pigatron-industries/xen_quantizer/README.md

# Quantizer

A Eurorack quantizer module

[Documentation](https://pigatron-industries.github.io/xen_quantizer/)
