pigatron-industries/xen_quantizer/docs/index.md

---
order: 1
---
# Quantizer

{% include img.html src="images/quantizer_panel.png" height="640" class="floatright" %}

A 4 channel quantizer and sequence generator

## Features
* 4 channel quantizer.
* Can quantize input using alternative tunings, scales and chords.
* Custom tunings and scales can be difined and read from SD card.
* Assignable CV inputs for controllable parameters.
* Includes sequence generation modes for generating sequences of voltages or triggers.
* Uses a Teensy microcontroller + open source code can easily be modified.

## Documentation

* [User Manual](user.md)
* [Bill of Materials](bom.md)
* [Build Guide](build.md)
