pigatron-industries/xen_quantizer/docs/images/quantizer_baseboard_brd.drawio.png

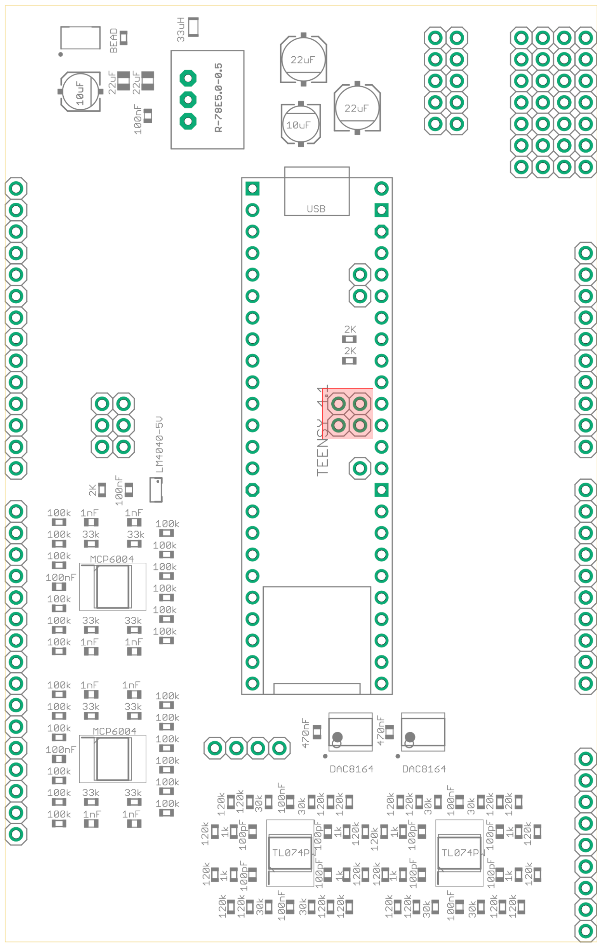
docs/images/quantizer_baseboard_brd.drawio.png
