pigatron-industries/xen_quantizer/docs/images/quantizer_panel.png

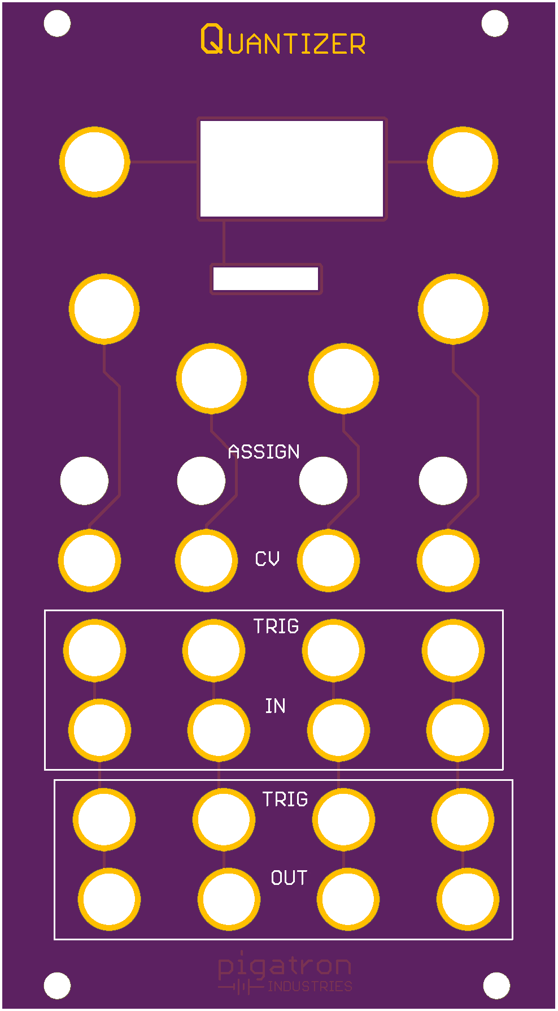
docs/images/quantizer_panel.png
