pigatron-industries/xen_quantizer/hardware/PGTN034_quantizer_mki_panel.png

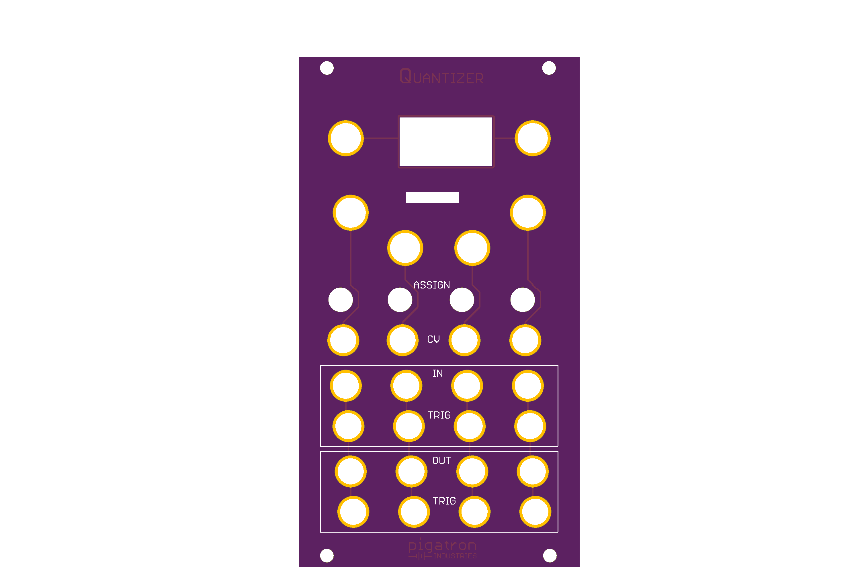
hardware/PGTN034_quantizer_mki_panel.png
