pigatron-industries/xen_quantizer/hardware/xen_teensy_motherboard_8cv8pt_mki.png

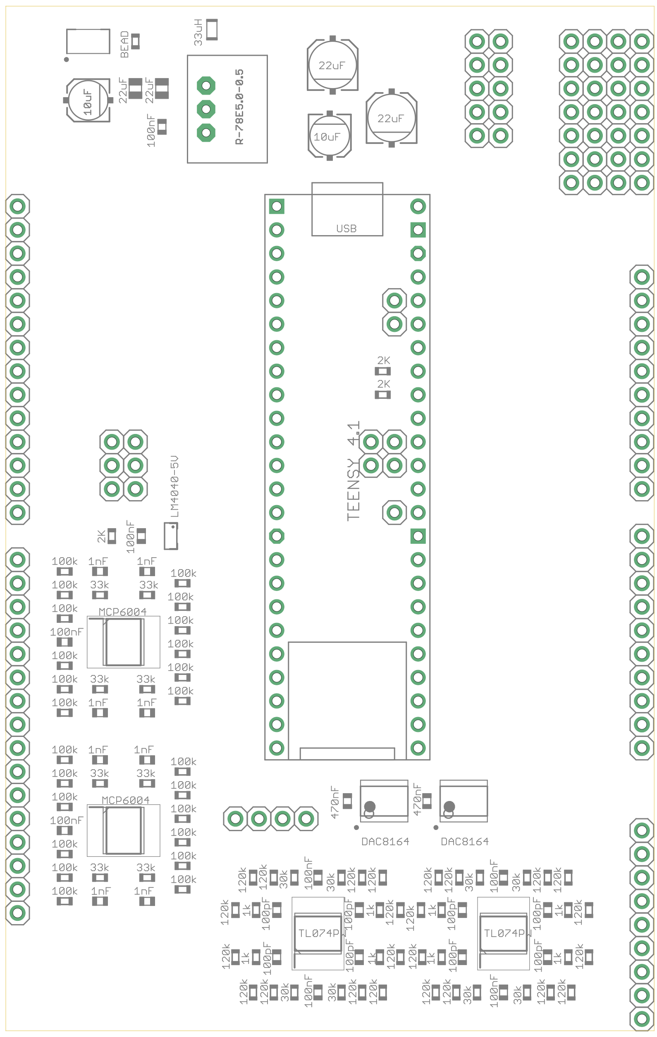
hardware/xen_teensy_motherboard_8cv8pt_mki.png
