pigatron-industries/xen_quantizer/docs/images/quantizer_panel_guide.drawio.png

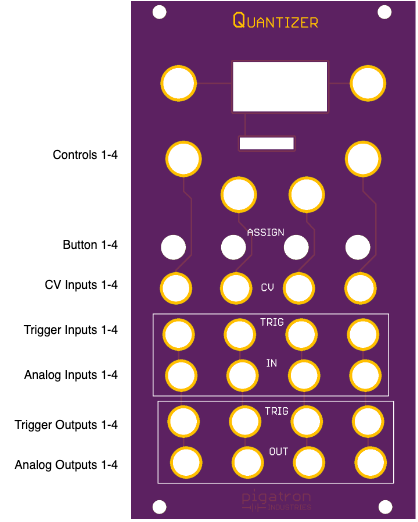
docs/images/quantizer_panel_guide.drawio.png
