pigatron-industries/xen_quantizer/hardware/PGTN034_quantizer_mki_controls.brd

## EAGLE design hardware/PGTN034_quantizer_mki_controls.brd (2024-04-14)

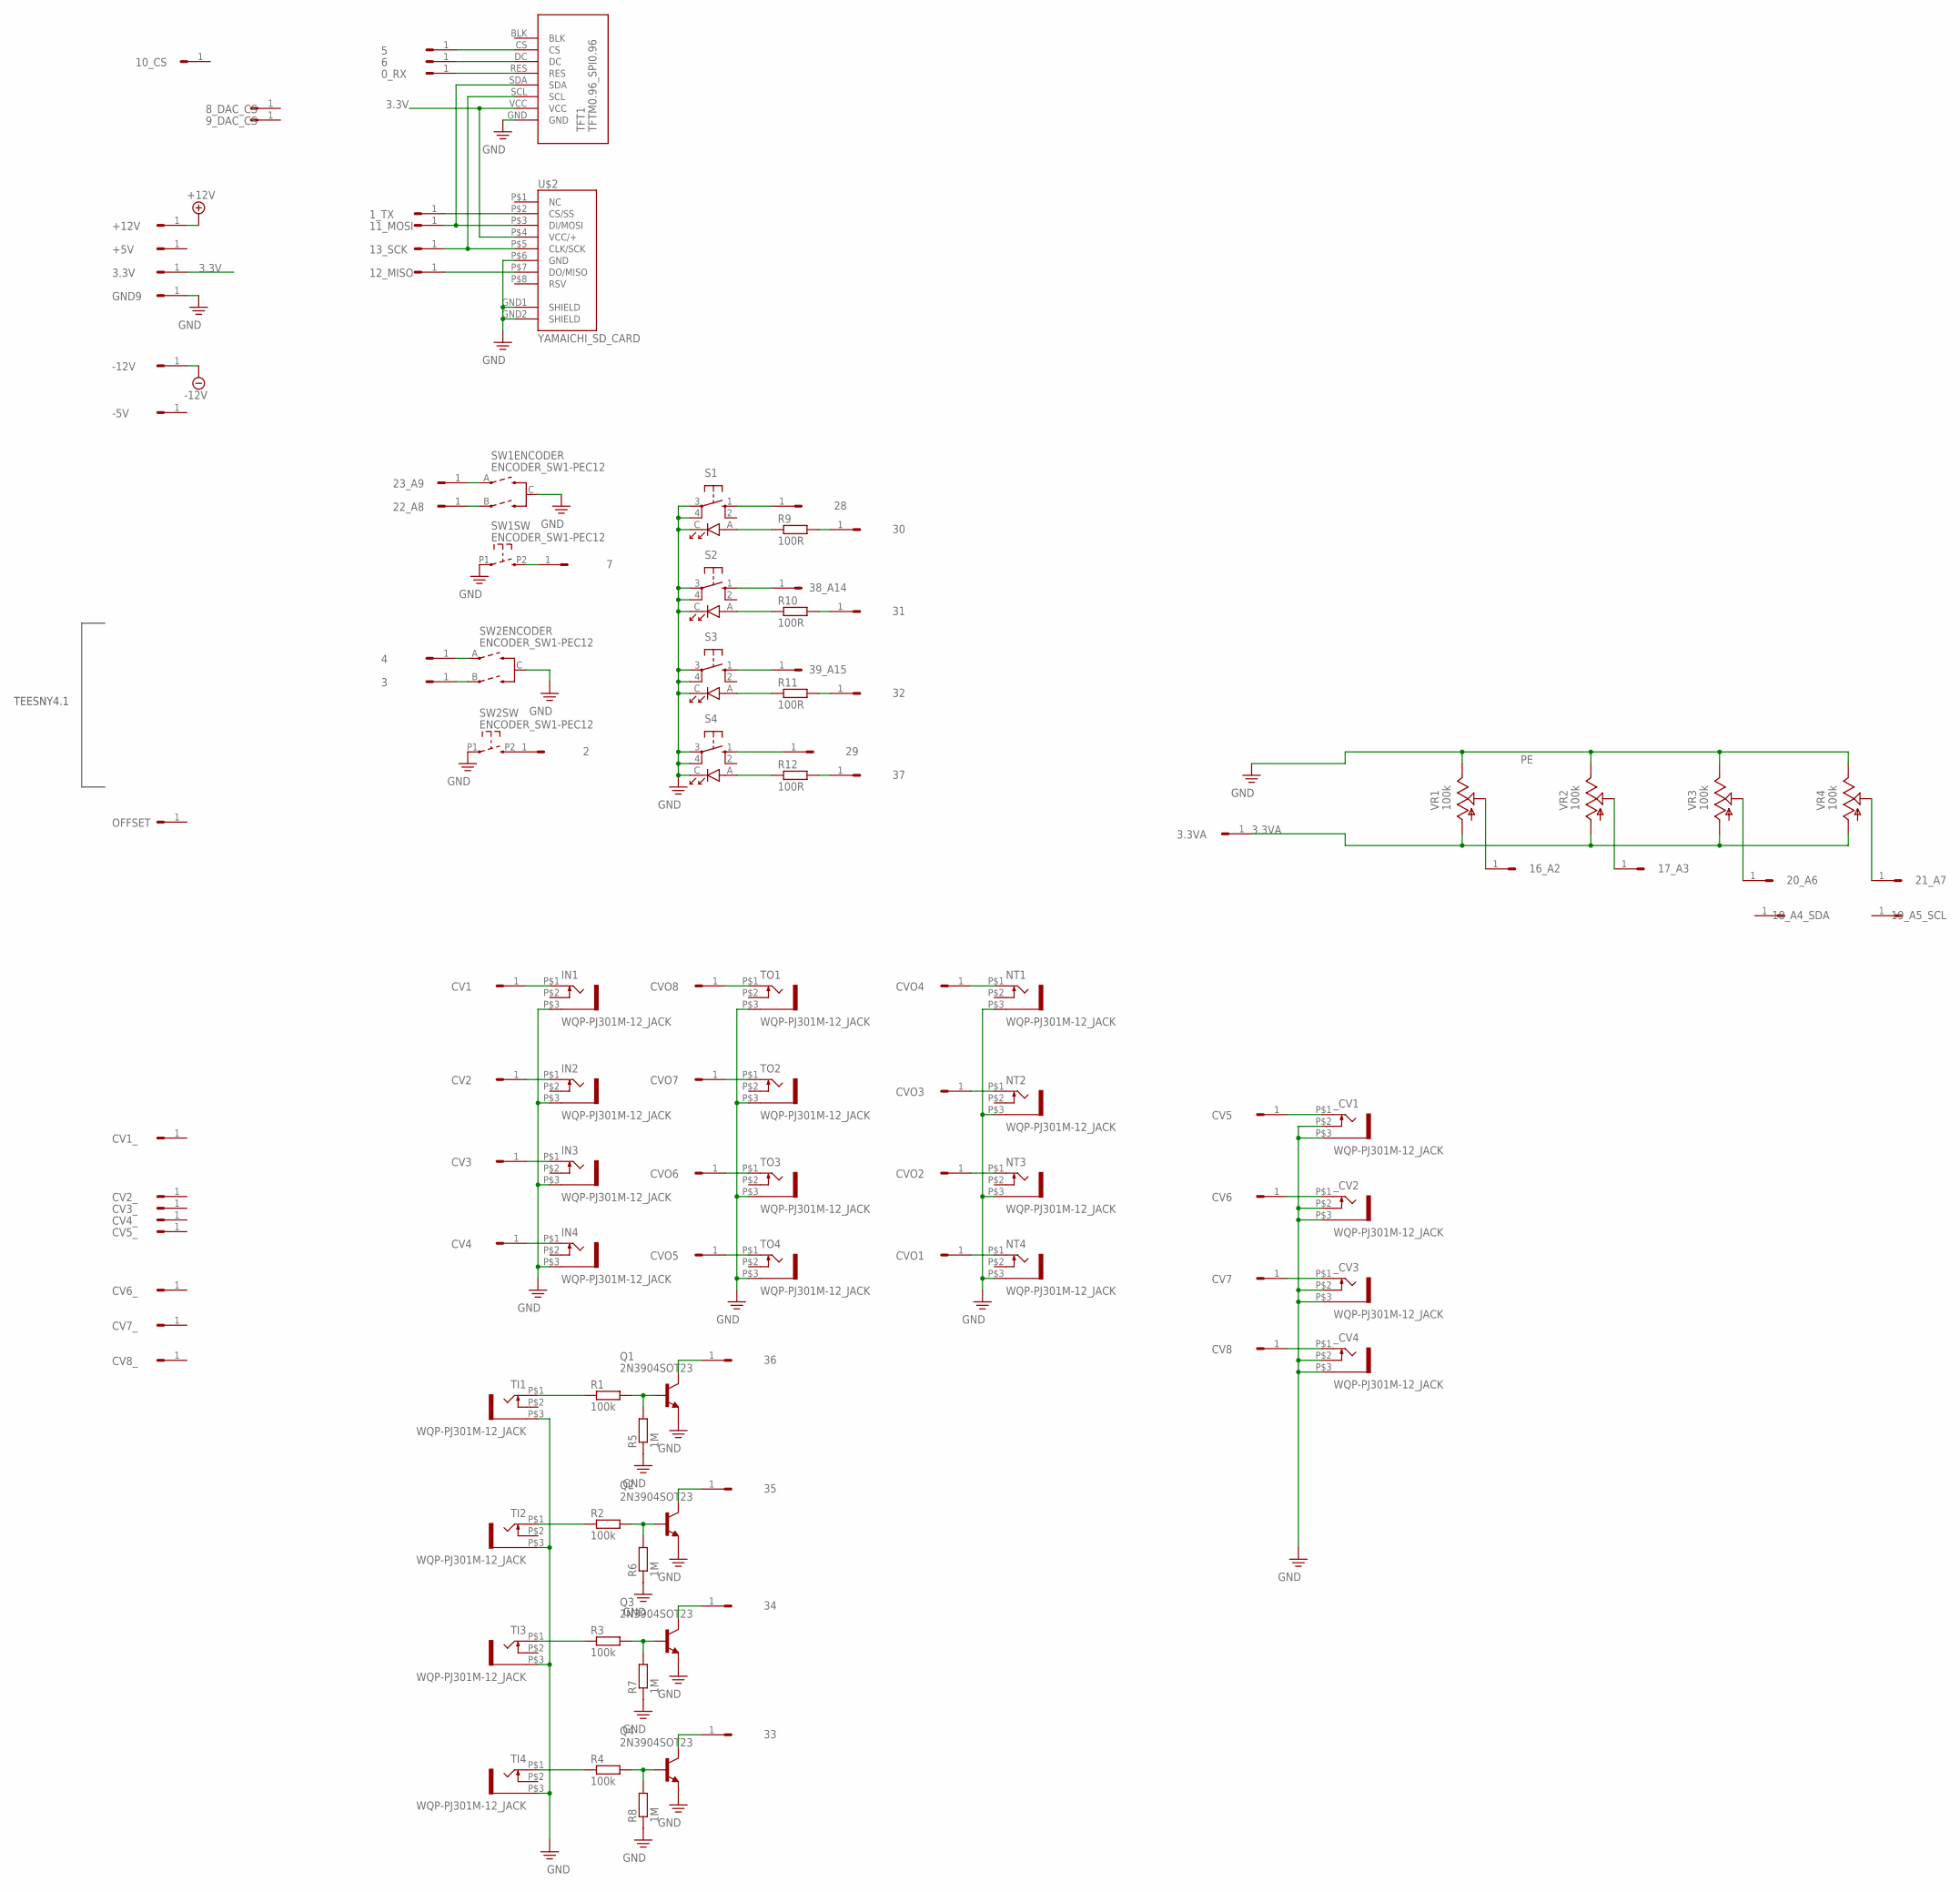
[picture p6: schematic PGTN034_quantizer_mki_controls.sch]

Parts:
0_RX, 1_TX, 2, 3, 3.3V, 3.3VA, 4, 5, 6, 7, 8_DAC_CS, 9_DAC_CS, 10_CS, 11_MOSI, 12_MISO, 13_SCK, 16_A2, 17_A3, 18_A4_SDA, 19_A5_SCL, 20_A6, 21_A7, 22_A8, 23_A9, 28, 29, 30, 31, 32, 33, 34, 35, 36, 37, 38_A14, 39_A15: HEADER/MALE/01
+5V, +12V: HEADER/MALE/01
-5V, -12V: HEADER/MALE/01
CV1, CV1_, CV2, CV2_, CV3, CV3_, CV4, CV4_, CV5, CV5_, CV6, CV6_, CV7, CV7_, CV8, CV8_: HEADER/MALE/01
CVO1, CVO2, CVO3, CVO4, CVO5, CVO6, CVO7, CVO8: HEADER/MALE/01
GND9: HEADER/MALE/01
IN1, IN2, IN3, IN4: WQP-PJ301M-12_JACK
NT1, NT2, NT3, NT4: WQP-PJ301M-12_JACK
OFFSET: HEADER/MALE/01
Q1, Q2, Q3, Q4: 2N3904SOT23; SOT23
R1, R2, R3, R4: 100k; R0603
R5, R6, R7, R8: 1M; R0603
R9, R10, R11, R12: 100R; R0603
S1, S2, S3, S4: SW-LEDTHONK; SW-PUSH-TACT-LED-THONK
SW1, SW2: ENCODER_SW1-PEC12; PEC12_INCREMENTAL_ENCODER
TFT1: TFTM0.96_SPI0.96; TFTM0.96
TI1, TI2, TI3, TI4: WQP-PJ301M-12_JACK
TO1, TO2, TO3, TO4: WQP-PJ301M-12_JACK
U$2: YAMAICHI_SD_CARD; YAMAICHI_MICROSD_VERTICAL
VR1, VR2, VR3, VR4: 100k; 9MM_SNAP-IN_POT
_CV1, _CV2, _CV3, _CV4: WQP-PJ301M-12_JACK

Connections:
3.3V: 3.3V.1, TFT1.VCC, U$2.P$4 (VCC/+)
3.3VA: 3.3VA.1, VR1.1 (A), VR2.1 (A), VR3.1 (A), VR4.1 (A)
+12V: +12V.1
-12V: -12V.1
unnamed: CV5.1, _CV1.P$1 (2)
unnamed: 16_A2.1, VR1.2 (S)
unnamed: CV6.1, _CV2.P$1 (2)
unnamed: 0_RX.1, TFT1.RES
unnamed: CVO1.1, NT4.P$1 (2)
unnamed: CVO2.1, NT3.P$1 (2)
unnamed: 17_A3.1, VR2.2 (S)
unnamed: CVO3.1, NT2.P$1 (2)
unnamed: 20_A6.1, VR3.2 (S)
unnamed: 21_A7.1, VR4.2 (S)
unnamed: CVO4.1, NT1.P$1 (2)
unnamed: CVO5.1, TO4.P$1 (2)
unnamed: CVO6.1, TO3.P$1 (2)
unnamed: CVO7.1, TO2.P$1 (2)
unnamed: CVO8.1, TO1.P$1 (2)
unnamed: CV1.1, IN1.P$1 (2)
unnamed: CV2.1, IN2.P$1 (2)
unnamed: CV3.1, IN3.P$1 (2)
unnamed: CV4.1, IN4.P$1 (2)
unnamed: CV7.1, _CV3.P$1 (2)
unnamed: CV8.1, _CV4.P$1 (2)
unnamed: R1.1, TI1.P$1 (2)
unnamed: R2.1, TI2.P$1 (2)
unnamed: R3.1, TI3.P$1 (2)
unnamed: R4.1, TI4.P$1 (2)
unnamed: Q1.1 (B), R1.2, R5.2
unnamed: Q2.1 (B), R2.2, R6.2
unnamed: Q3.1 (B), R3.2, R7.2
unnamed: Q4.1 (B), R4.2, R8.2
unnamed: 36.1, Q1.3 (C)
unnamed: 35.1, Q2.3 (C)
unnamed: 34.1, Q3.3 (C)
unnamed: 33.1, Q4.3 (C)
unnamed: R9.1, S1.A
unnamed: R12.1, S4.A
unnamed: 7.1, SW1.P2 (2)
unnamed: 23_A9.1, SW1.A
unnamed: 22_A8.1, SW1.B
unnamed: R11.1, S3.A
unnamed: R10.1, S2.A
unnamed: 28.1, S1.1 (S)
unnamed: 38_A14.1, S2.1 (S)
unnamed: 39_A15.1, S3.1 (S)
unnamed: 29.1, S4.1 (S)
unnamed: 31.1, R10.2
unnamed: 30.1, R9.2
unnamed: 32.1, R11.2
unnamed: 37.1, R12.2
unnamed: 12_MISO.1, U$2.P$7 (DO/MISO)
unnamed: 11_MOSI.1, TFT1.SDA, U$2.P$3 (DI/MOSI)
unnamed: 13_SCK.1, TFT1.SCL, U$2.P$5 (CLK/SCK)
unnamed: 5.1, TFT1.CS
unnamed: 6.1, TFT1.DC
unnamed: 3.1, SW2.B
unnamed: 4.1, SW2.A
unnamed: 2.1, SW2.P2 (2)
unnamed: 1_TX.1, U$2.P$2 (CS/SS)
PE: GND9.1, IN1.P$3 (1), IN2.P$3 (1), IN3.P$3 (1), IN4.P$3 (1), NT1.P$3 (1), NT2.P$3 (1), NT3.P$3 (1), NT4.P$3 (1), Q1.2 (E), Q2.2 (E), Q3.2 (E), Q4.2 (E), R5.1, R6.1, R7.1, R8.1, S1.3, S1.4 (P1), S1.C, S2.3, S2.4 (P1), S2.C, S3.3, S3.4 (P1), S3.C, S4.3, S4.4 (P1), S4.C, SW1.C, SW1.P1 (1), SW2.C, SW2.P1 (1), TFT1.GND, TI1.P$3 (1), TI2.P$3 (1), TI3.P$3 (1), TI4.P$3 (1), TO1.P$3 (1), TO2.P$3 (1), TO3.P$3 (1), TO4.P$3 (1), U$2.GND1 (SHIELD), U$2.GND2 (SHIELD), U$2.P$6 (GND), VR1.3 (E), VR2.3 (E), VR3.3 (E), VR4.3 (E), _CV1.P$2 (3), _CV1.P$3 (1), _CV2.P$2 (3), _CV2.P$3 (1), _CV3.P$2 (3), _CV3.P$3 (1), _CV4.P$2 (3), _CV4.P$3 (1)

Notes on the sheet:
TEESNY4.1

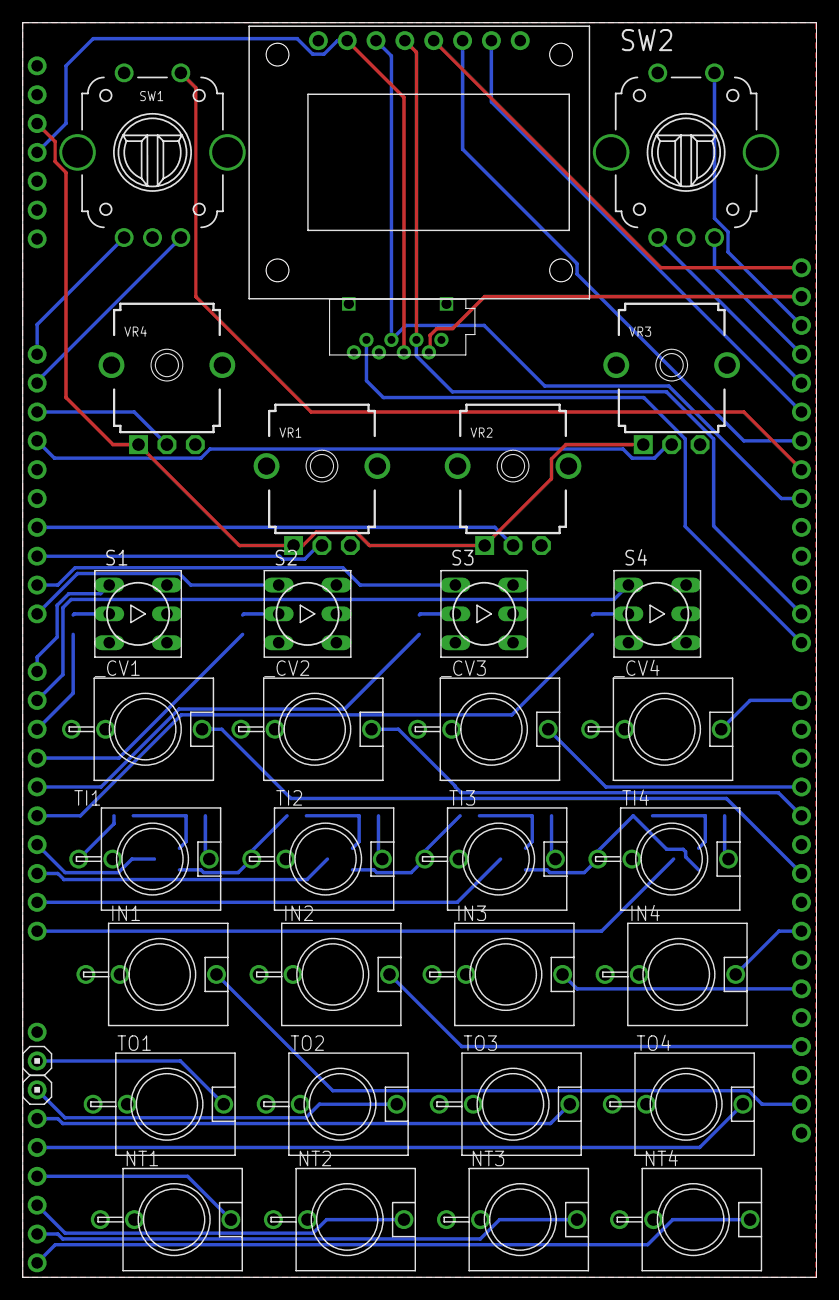
[picture p7: board PGTN034_quantizer_mki_controls.brd from above]

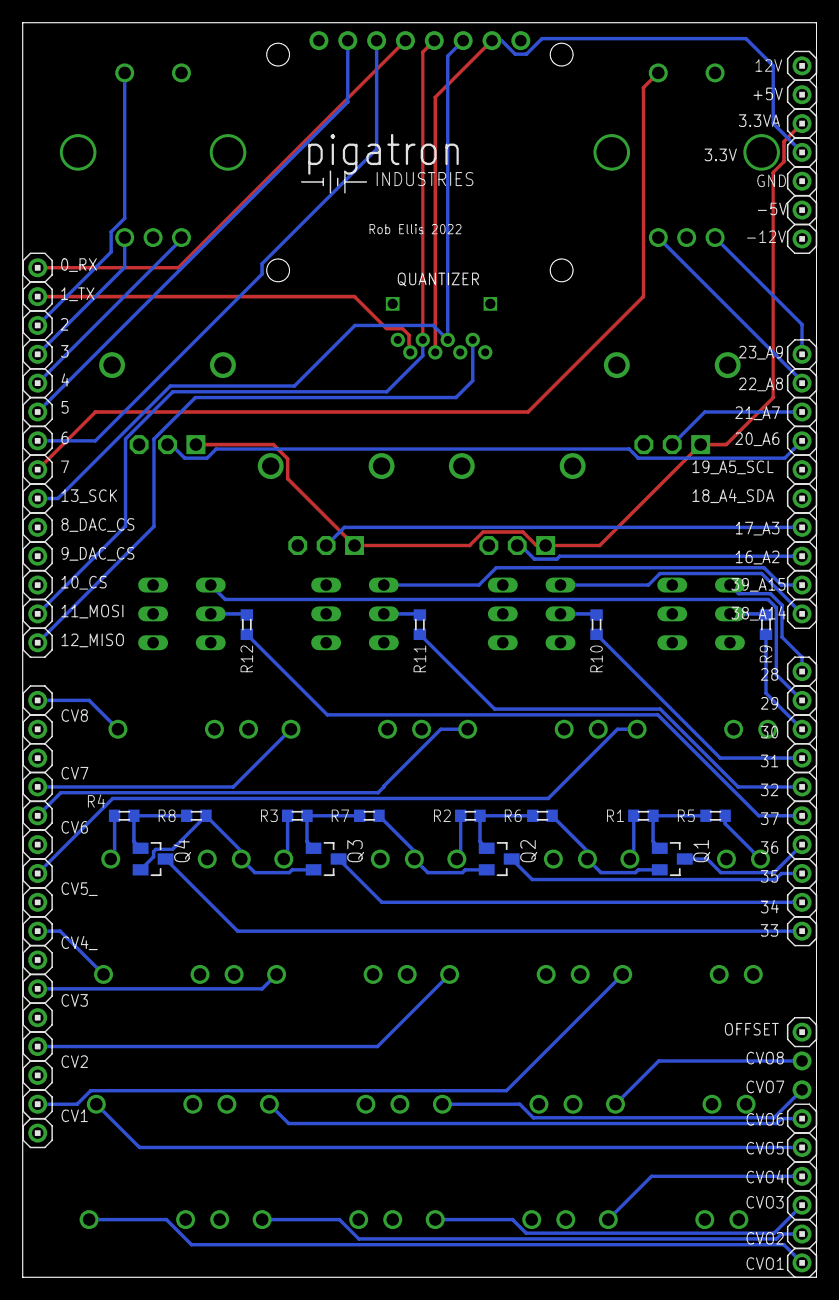
[picture p8: board PGTN034_quantizer_mki_controls.brd from below]

Board: 2 copper layers, 69.9 x 110.5 mm, 115 parts (81 on the bottom side), 60 nets.

Other parts of the board:
U$1: PIGATRON-LOGO
