pigatron-industries/xen_quantizer/hardware/PGTN034_quantizer_mki_panel.brd

## EAGLE design hardware/PGTN034_quantizer_mki_panel.brd (2023-10-22)

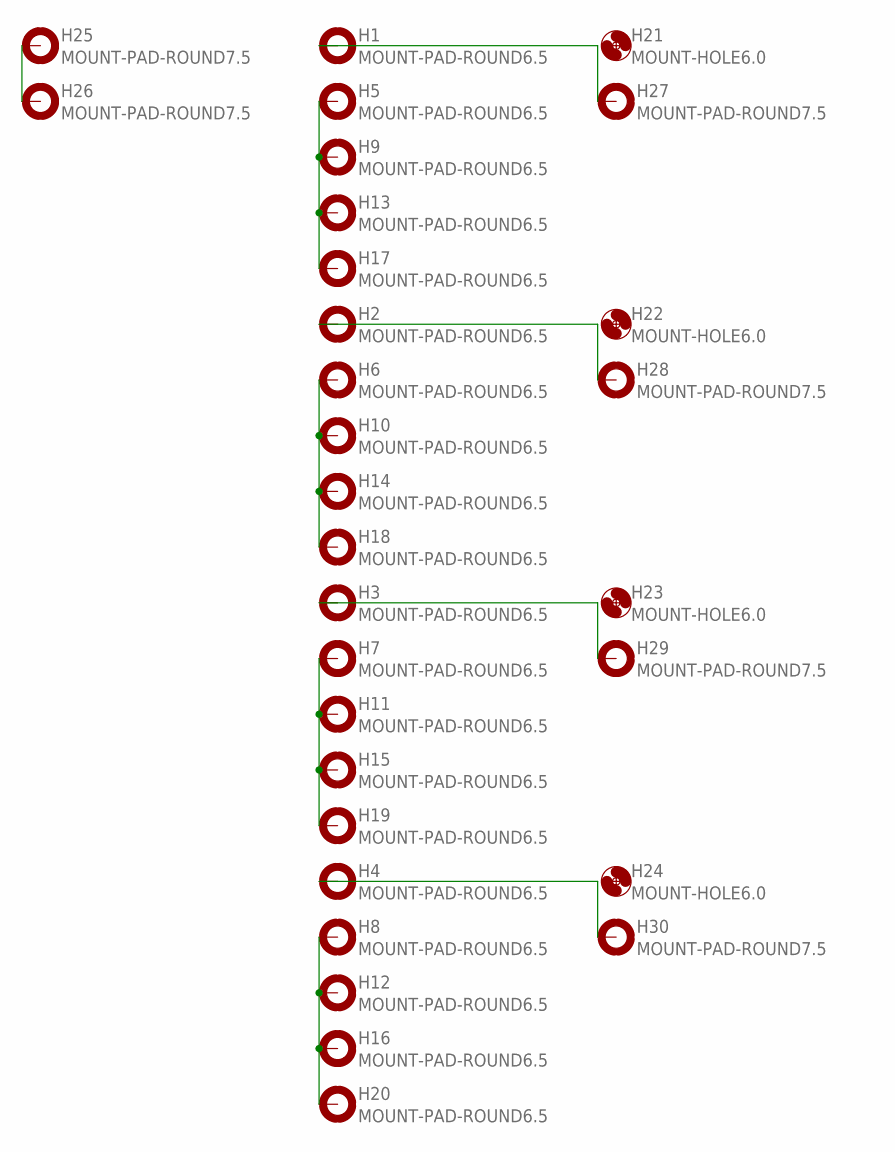
[picture p9: schematic PGTN034_quantizer_mki_panel.sch]

Parts:
H1, H2, H3, H4, H5, H6, H7, H8, H9, H10, H11, H12, H13, H14, H15, H16, H17, H18, H19, H20: MOUNT-PAD-ROUND6.5; 6.5-PAD
H21, H22, H23, H24: MOUNT-HOLE6.0; 6,0
H25, H26, H27, H28, H29, H30: MOUNT-PAD-ROUND7.5; 7.5-PAD

Connections:
unnamed: H5.B6.5, H9.B6.5, H13.B6.5, H17.B6.5
unnamed: H6.B6.5, H10.B6.5, H14.B6.5, H18.B6.5
unnamed: H7.B6.5, H11.B6.5, H15.B6.5, H19.B6.5
unnamed: H8.B6.5, H12.B6.5, H16.B6.5, H20.B6.5
unnamed: H2.B6.5, H28.B7.5
unnamed: H3.B6.5, H29.B7.5
unnamed: H4.B6.5, H30.B7.5
unnamed: H25.B7.5, H26.B7.5
unnamed: H1.B6.5, H27.B7.5

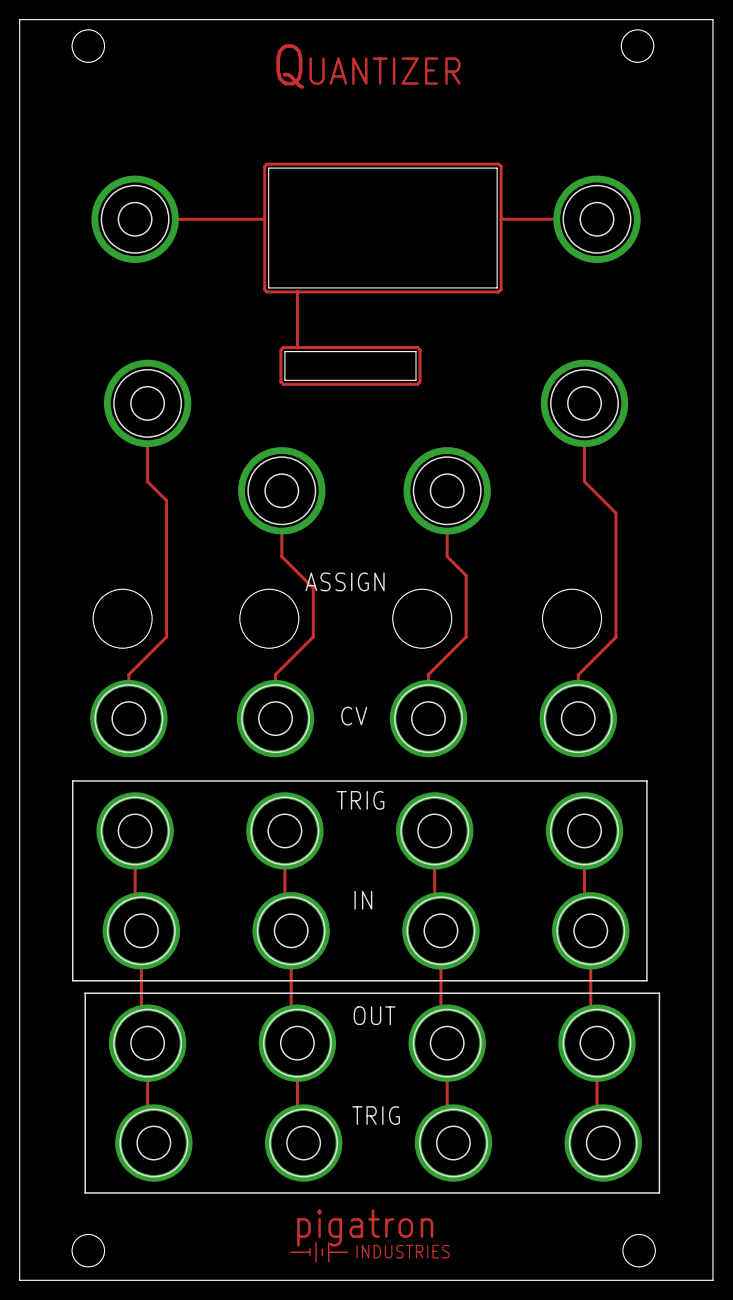
[picture p10: board PGTN034_quantizer_mki_panel.brd from above]

Board: 2 copper layers, 70.5 x 128.3 mm, 35 parts (0 on the bottom side), 9 nets.

Other parts of the board:
U$2: PIGATRON-LOGO-TRACE
U$3, U$4, U$5, U$6: 3,3
