pigatron-industries/xen_quantizer/src/hwconfig.h

// Teensy Pins
#define ENCODER1_BTN_PIN 7
#define ENCODER1_PIN1 22
#define ENCODER1_PIN2 23
#define ENCODER2_BTN_PIN 2
#define ENCODER2_PIN1 3
#define ENCODER2_PIN2 4
#define DAC1_CS_PIN 9
#define DAC2_CS_PIN 8
#define SD_CS_PIN 1

//GPIO expander
#define GPIO_CS_PIN 10
#define GPIO_ADDRESS 0x20

// Other config
#define SERIAL_BAUD 115200
#define SAMPLE_RATE 1000

#define CHANNEL_COUNT 4
