pigatron-industries/xen_quantizer/src/main.cpp

#include <Arduino.h>
#include <eurorack.h>
#include <SPI.h>
#include "hwconfig.h"
#include "MainController.h"

MainController mainController = MainController(SAMPLE_RATE);


void setup() {
    Serial.begin(SERIAL_BAUD);
    Serial.println();
    Serial.println("=========================================");
    Serial.println("*     Pigatron Industries Quantizer     *");
    Serial.println("=========================================");
    Serial.println();

    mainController.init();
}

void loop() {
    mainController.update();
}
