pigatron-industries/xen_quantizer/src/MainController.h

#ifndef MainController_h
#define MainController_h

#include <eurorack.h>
#include <inttypes.h>

#include "Controller.h"
#include "Hardware.h"
#include "apps.h"

class MainController : DoubleEncoderController<Controller, CONTROLLERS> {

public:
    MainController(float sampleRate);
    void init();
    void update();
    void process();

private:
    float sampleRate;

    void controllerInit();

    IntervalTimer interruptTimer;
    static MainController* mainController;
    static void interruptHandler();
};

#endif
