pigatron-industries/xen_quantizer/src/controllers/neuralsequencer/SequencerController.cpp

#include "SequencerController.h"

void SequencerController::init(float sampleRate) {
    Controller::init(sampleRate);
    modelManager.init();
    configParam(Parameter::MODEL, 0, modelManager.getModelCount()-1);
    interface.init();
    interface.focusModel();
    setModel(parameters[Parameter::MODEL].value);
    init();
}

void SequencerController::init() {
    Serial.println("Sequencer");
    interface.render();
}

int SequencerController::cycleParameter(int amount) {
    parameters.cycle(amount);
    switch(parameters.getSelectedIndex()) {
        case Parameter::MODEL:
            interface.focusModel();
            break;
    }

    return parameters.getSelectedIndex(); 
}

void SequencerController::cycleValue(int amount) {
    parameters.getSelected().cycle(amount);
    switch(parameters.getSelectedIndex()) {
        case Parameter::MODEL:
            setModel(parameters[Parameter::MODEL].value);
            break;
    }

    save();
}

void SequencerController::setModel(int index) {
    Serial.print("setModel:");
    Serial.println(index);
    modelManager.loadModel(index);
    if(model.checkType("seqdec")) {
        sequenceDecoderModel.init();
    } else {
        Serial.println("ERROR: unknown model type");
    }

    interface.setModel(model.getName());
    interface.render();
}

void SequencerController::update() {

    if(Hardware::hw.pushButtons[0].update()) {
        if(Hardware::hw.pushButtons[0].pressed()) {
            Serial.println("button 1 press");
            Hardware::hw.led1OutputPin.digitalWrite(!Hardware::hw.led1OutputPin.getDigitalValue());
        } else if(Hardware::hw.pushButtons[0].released()) {

        }
    }

    if(Hardware::hw.pushButtons[1].update() && Hardware::hw.pushButtons[1].pressed()) {
        Serial.println("button 2 press");
        Hardware::hw.led2OutputPin.digitalWrite(!Hardware::hw.led2OutputPin.getDigitalValue());
    }

    if(Hardware::hw.pushButtons[2].update() && Hardware::hw.pushButtons[2].pressed()) {
        Serial.println("button 3 press");
        Hardware::hw.led3OutputPin.digitalWrite(!Hardware::hw.led3OutputPin.getDigitalValue());
    }

    if(Hardware::hw.pushButtons[3].update() && Hardware::hw.pushButtons[3].pressed()) {
        Serial.println("button 4 press");
        Hardware::hw.led4OutputPin.digitalWrite(!Hardware::hw.led4OutputPin.getDigitalValue());
    }
}


void SequencerController::process() {
    for(int i = 0; i < NUM_NOTE_OUTPUTS; i++) {
        triggerOutputs[i].update();
    }

    if(resetInput.update() && resetInput.rose()) {
        delay(1);
        reset();
    }

    if(clockInput.update() && clockInput.rose()) {
        delay(1);
        tick();
    }
}


void SequencerController::reset() {
    sequenceDecoderModel.reset();
}

void SequencerController::tick() {
    thresholdInput.update();
    thresholdCVInput.update();

    if (sequenceDecoderModel.tick() == 0) {
        runInference();
        Serial.println("inference");
    }

    OutputNote* notes = sequenceDecoderModel.getOutputNotes();
    float threshold = thresholdInput.getValue() + thresholdCVInput.getValue();
    // Serial.print("notes: ");
    for(int i = 0; i < NUM_NOTE_OUTPUTS; i++) {
        // Serial.print(" ");
        // Serial.print(notes[i].note);
        // Serial.print(" ");
        // Serial.print(notes[i].probability);
        if(notes[i].probability > threshold) {
            float voltage = notes[i].note * 1.0f / 12.0f;  //TODO convert note number into voltage using scale
            Hardware::hw.cvOutputPins[i]->analogWrite(voltage);
            triggerOutputs[i].trigger(); //TODO gate or trigger?
        }
    }
    // Serial.println();
}


void SequencerController::runInference() {
    latent1Input.update();
    latent2Input.update();
    latent3Input.update();
    latent1CVInput.update();
    latent2CVInput.update();
    latent3CVInput.update();
    // Serial.println(latent1CVInput.getValue());
    // Serial.println(latent2CVInput.getValue());
    // Serial.println(latent3CVInput.getValue());
    model.setInput(0, latent1Input.getValue() + latent1CVInput.getValue());
    model.setInput(1, latent2Input.getValue() + latent2CVInput.getValue());
    model.setInput(2, latent3Input.getValue() + latent3CVInput.getValue());
    model.runInference();
}
