pigatron-industries/xen_quantizer/src/controllers/sequencer/SequencerInterface.cpp

#include "SequencerInterface.h"

void SequencerInterface::init() {
    page.addComponent(&title);
    page.addComponent(&patternField);
    page.addComponent(&sequencerVisualiser);

    page.setContext(&Hardware::hw.display);
    page.layout();
    
    messageBox.setContext(&Hardware::hw.display);
    messageBox.layout();
}

void SequencerInterface::render() {
    Hardware::hw.display.clear();
    page.render();
}
