pigatron-industries/xen_quantizer/src/controllers/midi/MidiConstants.h

#define COMMAND_NOTEOFF 0x8
#define COMMAND_NOTEON 0x9
#define COMMAND_POLY_PRESSURE 0xA
#define COMMAND_CONTROL_CHANGE 0xB
#define COMMAND_PROGRAM_CHANGE 0xC
#define COMMAND_CHAN_PRESSURE 0xD
#define COMMAND_PITCH_BEND 0xE
#define COMMAND_SYSTEM 0xF

#define CONTROL_MUTE 0x7B
#define CONTROL_RPN_PARAM_LSB 0x64
#define CONTROL_RPN_PARAM_MSB 0x65
#define CONTROL_RPN_VALUE_COARSE 0x06
#define CONTROL_RPN_VALUE_FINE 0x26

#define RPN_PARAM_PITCH_BEND_RANGE 0x00

#define SYSTEM_EXCLUSIVE 0x0
#define SYSTEM_SONG_POSITION 0x2
#define SYSTEM_CLOCK 0x8
#define SYSTEM_START 0xA
#define SYSTEM_CONTINUE 0xA
#define SYSTEM_STOP 0xC
#define SYSTEM_RESET 0xF

#define SYSTEM_EXCLUSIVE_ID 0x7D
#define SYSTEM_EXCLUSIVE_END 0xF7


#define HI_NYBBLE(b) (((b) >> 4) & 0x0F)
#define LO_NYBBLE(b) ((b) & 0x0F)
