pigatron-industries/xen_quantizer/src/controllers/generativedecoder/SequenceDecoderInterface.h

#ifndef SequenceDecoderInterface_h
#define SequenceDecoderInterface_h

#include <eurorack_graphics.h>
#include "Hardware.h"
#include "SequenceVisualiser.h"

class SequenceDecoderInterface {
    public:
        SequenceDecoderInterface(const char* titleText) : title(TFTDisplay::WIDTH, titleText, 2, TFT_ORANGE) {}
        void init();
        void render();

        void setModel(char* modelName);
        void setSequence(OutputNotesSequence* sequence);
        void setCurrentTick(int8_t tick);
        void focusModel();

        SequenceVisualiser<TFTDisplay> sequenceVisualiser = SequenceVisualiser<TFTDisplay>(TFTDisplay::WIDTH, 12*3);

    private:
        FocusManager<TFTDisplay> focusManager;

        VerticalContainer<TFTDisplay, 4> page;
        TextComponent<TFTDisplay> title;
        FieldComponent<TFTDisplay> modelField = FieldComponent<TFTDisplay>(TFTDisplay::WIDTH, 50, "MODEL:");

        MessageBoxComponent<TFTDisplay> messageBox = MessageBoxComponent<TFTDisplay>(TFTDisplay::WIDTH*0.5, TFTDisplay::HEIGHT*0.5, 2, TFT_ORANGE);
};

#endif
