pigatron-industries/xen_quantizer/src/controllers/scalechordquantizer/NoteVisualiserImpl.h

#include "NoteVisualiser.h"

template<class G>
NoteVisualiser<G>::NoteVisualiser(uint16_t width, uint16_t height) {
    this->setWidth(width);
    this->setHeight(height);
}

// template<class G>
// void NoteVisualiser<G>::layout() {
// }

template<class G>
void NoteVisualiser<G>::render() {
    this->graphicsContext->fillRectangle(this->getLeft(), this->getTop(), this->getWidth(), this->getHeight(), TFT_BLACK);
    renderTuning();
}

template<class G>
void NoteVisualiser<G>::renderTuning() {
    if(tuning != nullptr) {
        int16_t noteLeft = this->getLeft();
        if(scale != nullptr) {
            noteLeft = noteLeft + int(roundf(scale->getOffset()*tuning->size()))*noteWidth;
            Serial.println(scale->getOffset());
            Serial.println(noteWidth);
            Serial.println(noteLeft);
            if(noteLeft < 0) {
                noteLeft += tuningWidth;
            }
        }
        for(int i = 0; i < tuning->size(); i++) {
            renderNote(i, noteLeft);
            noteLeft += noteWidth;
            noteLeft %= tuningWidth;
        }
    }
}

template<class G>
void NoteVisualiser<G>::renderNote(int note, uint16_t noteLeft) {
    uint16_t colour = TFT_NAVY;
    if(scale != nullptr && scale->containsNote(note)) {
        colour = TFT_MAROON;
    }
    if(chord != nullptr) {
        if((*chord)[0].note == note) {
            colour = TFT_GREEN;
        } else if ((*chord)[1].note == note) {
            colour = TFT_RED;
        } else if ((*chord)[2].note == note) {
            colour = TFT_RED;
        }
    }
    this->graphicsContext->fillRectangle(noteLeft, this->getTop(), noteWidth-1, this->getHeight(), colour);
}

template<class G>
void NoteVisualiser<G>::setTuning(Tuning* tuning) { 
    this->tuning = tuning; 
    noteWidth = this->getWidth() / tuning->size();
    tuningWidth = noteWidth * tuning->size();
    this->render();
}

template<class G>
void NoteVisualiser<G>::setScale(Scale* scale) { 
    this->scale = scale;
    setTuning(scale->getTuning());
}

template<class G>
void NoteVisualiser<G>::setChord(Chord* chord) {
    this->chord = chord;
    this->renderTuning();
}
