pigatron-industries/xen_quantizer/src/controllers/scalechordquantizer/ScaleChordInterface.h

#ifndef ScaleChordInterface_h
#define ScaleChordInterface_h

#include <eurorack_graphics.h>
#include "Hardware.h"
#include "NoteVisualiser.h"

class ScaleChordInterface {
    public:
        ScaleChordInterface() {}
        void init();
        void render();

        void setTuningName(char* name);
        void setTuning(Tuning* tuning);
        void setScale(Scale* scale);
        void setChordDef(ChordDef* chordDef);
        void setChord(Chord* chord);
        void setOffset(int offset);

        void focusTuning();
        void focusScale();
        void focusChord();
        void focusOffset();

        void showMessage(const char* message);

    private:
        FocusManager<TFTDisplay> focusManager;

        VerticalContainer<TFTDisplay, 7> page;
        TextComponent<TFTDisplay> title = TextComponent<TFTDisplay>(TFTDisplay::WIDTH, "CHORD QUANTIZER", 2, TFT_ORANGE);
        FieldComponent<TFTDisplay> tuningField = FieldComponent<TFTDisplay>(TFTDisplay::WIDTH, 50, "TUNING:");
        FieldComponent<TFTDisplay> scaleField  = FieldComponent<TFTDisplay>(TFTDisplay::WIDTH, 50, "SCALE:");
        FieldComponent<TFTDisplay> chordField  = FieldComponent<TFTDisplay>(TFTDisplay::WIDTH, 50, "CHORD:");
        FieldComponent<TFTDisplay> offsetField = FieldComponent<TFTDisplay>(TFTDisplay::WIDTH, 50, "OFFSET:");
        NoteVisualiser<TFTDisplay> noteVisualiser = NoteVisualiser<TFTDisplay>(TFTDisplay::WIDTH, 10);

        MessageBoxComponent<TFTDisplay> messageBox = MessageBoxComponent<TFTDisplay>(TFTDisplay::WIDTH*0.5, TFTDisplay::HEIGHT*0.5, 2, TFT_ORANGE);
};

#endif
