pigatron-industries/xen_quantizer/src/controllers/quantizer/Scale.cpp

#include "Scale.h"

void Scale::enable(int note, bool enabled = true) { 
    if(note > 0) { 
        intervals[note-1].enabled = enabled; 
    }
}

void Scale::enable(std::initializer_list<int> notes) {
    for(int i = 0; i < intervals.size(); i++) {
        intervals[i].enabled = false;
    }
    for(int note : notes) {
        enable(note);
    }
}
