pigatron-industries/xen_quantizer/src/controllers/calibration/CalibrationController.h

#ifndef CalibrationController_h
#define CalibrationController_h

#include "Controller.h"
#include "CalibrationInterface.h"

class CalibrationController : public ParameterizedController<1> {
    public:

        enum Parameter {
            VALUE = 0
        };

        CalibrationController() : ParameterizedController() {}
        virtual void init(float sampleRate);
        virtual void init();
        virtual int cycleParameter(int amount);
        virtual void cycleValue(int amount);
        virtual void selectValue();
        virtual void update();
        virtual void process();

    private:
        IntegerInput<AnalogInputPinT> octaveInput = IntegerInput<AnalogInputPinT>(Hardware::hw.channel1PotPin, -5, 5, -4, 4);
        IntegerInput<AnalogInputPinT> channelInput = IntegerInput<AnalogInputPinT>(Hardware::hw.channel2PotPin, -5, 5, 0, 7);

        uint8_t currentOutput = 0;
        int8_t currentVoltage = 0;
        AnalogPinCalibration calibration;
        CalibrationInterface interface;

        void setOutput(uint8_t output);
        void setValue(int8_t amount);

        void startCalibrate();
        void saveCalibration();
        void updateOutput();
};

#endif
