pigatron-industries/xen_quantizer/(commit log)

2022-04-29 Pitch quantizer
2022-05-29 Quantize to current chord
2022-06-18 Select scales and tunings with encoder
2022-07-31 Changed encoder and trigger input pins
    [PGTN034_quantizer_mki_controls.brd, PGTN034_quantizer_mki_controls.sch, PGTN034_quantizer_mki_panel.brd, PGTN034_quantizer_mki_panel.sch]
2022-08-05 Fixed SPI interrupt clash
    [CalibrationController.cpp, MainController.cpp]
2022-08-06 Added calibration interface
2022-08-06 Zero outputs on calibration
2022-08-12 implement 2 encoder control scheme
2022-08-14 Fix issue with changing tuning
    [ScaleChordController.cpp]
2022-09-12 Add SPI SD Card
2022-09-20 set offset when changing scale
    [PGTN034_quantizer_mki_controls.brd, PGTN034_quantizer_mki_controls.sch]
2023-05-28 add sequencer controller
    [PGTN034_quantizer_mki_controls.brd]
2023-06-27 run inference and output note voltages
2023-07-09 add reset trigger input for sequencer
    [SequencerController.cpp, SequencerController.h]
2023-07-14 Use double encoder controller from library
2023-10-01 calibration insterface
2023-10-22 add current sequence position to ui
2023-10-28 add bill of materials
2023-10-29 display scale and offset while calibrating
2023-12-09 clear interface tick on sequence reset
    [SequenceDecoderController.cpp, SequenceVisualiser.h, SequenceVisualiserImpl.h, SequencerInterface.cpp, SequencerInterface.h]
2023-12-31 fix chord quantizer issue
    [ScaleChordController.cpp]
2024-01-14 calibration UI changes
2024-04-14 add sd card reader and spacers to bom
2024-04-14 add build guide
    [PGTN034_quantizer_mki_controls.brd]
2024-05-05 read/write from mutliple midi devices
2024-05-19 allow quantizer outputs to be fixed to chord or free
    [Hardware.h, NoteVisualiserImpl.h, ScaleChordController.cpp, ScaleChordController.h]
2024-06-04 pitch bend and rpn parameters
